WadeXl/bym-kestrel/renders/02_top.png

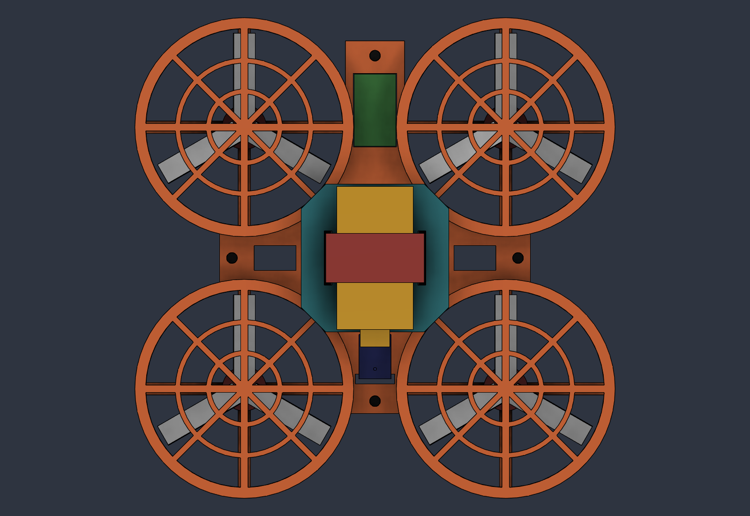
renders/02_top.png
