WadeXl/bym-kestrel/renders/03_front.png

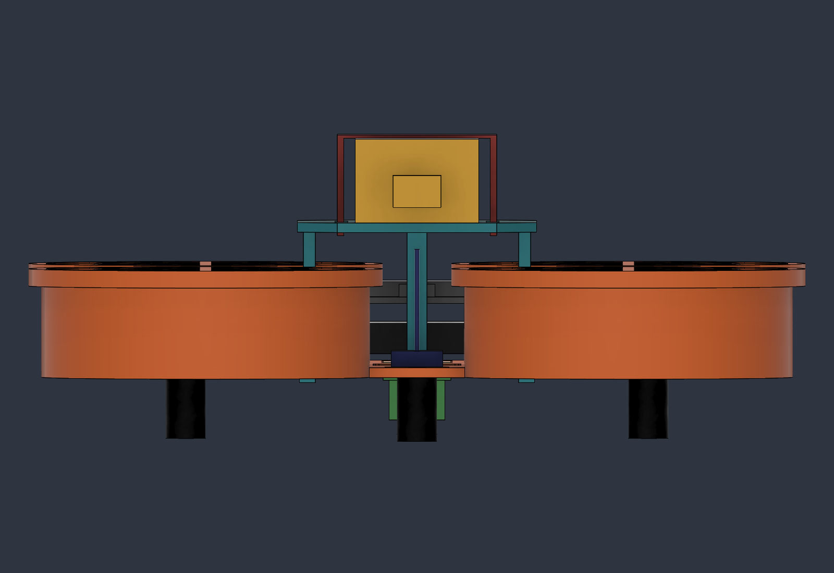
renders/03_front.png
