WadeXl/bym-kestrel/renders/04_bottom_flow_sensor.png

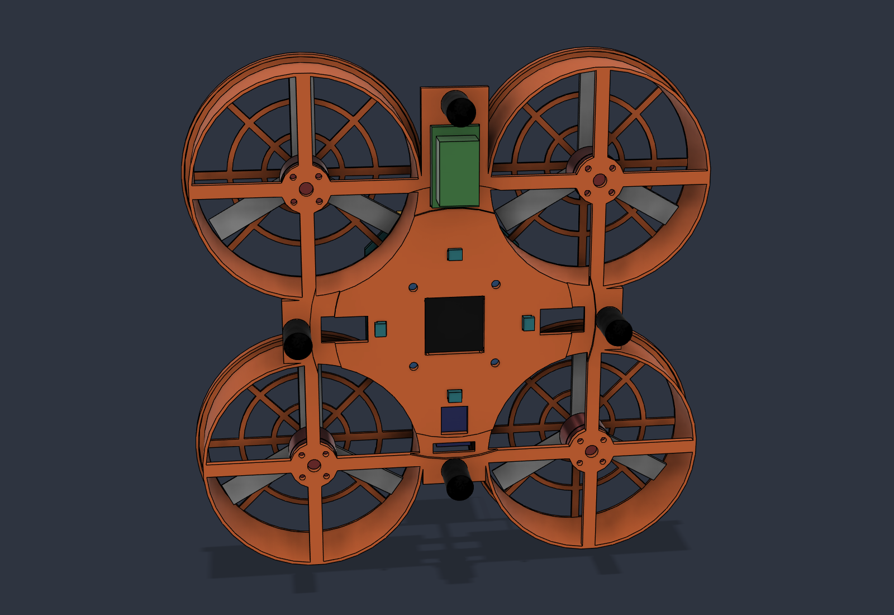
renders/04_bottom_flow_sensor.png
