WadeXl/bym-kestrel/renders/05_with_remote_bridge.png

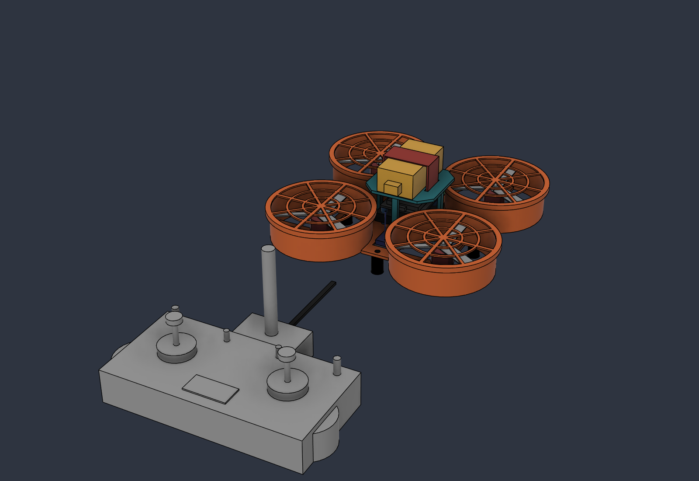
renders/05_with_remote_bridge.png
