WadeXl/bym-kestrel/renders/06_exploded.png

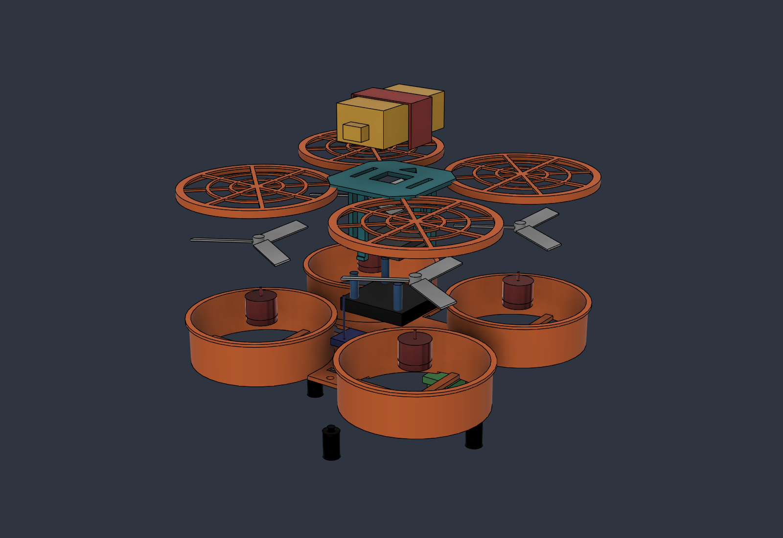
renders/06_exploded.png
