WadeXl/bym-kestrel/cad/K1_Assembly.step

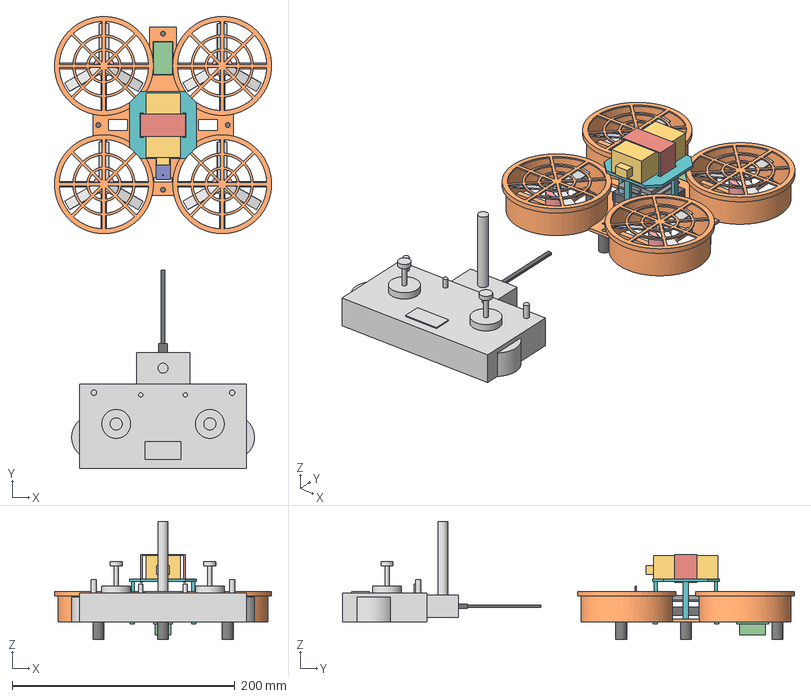
[picture p7: CAD file, 2026-11-09]
cad/K1_Assembly.step
194.8 x 405.4 x 106.0 mm
