WadeXl/bym-kestrel/cad/K1_P03_FingerGuard.step

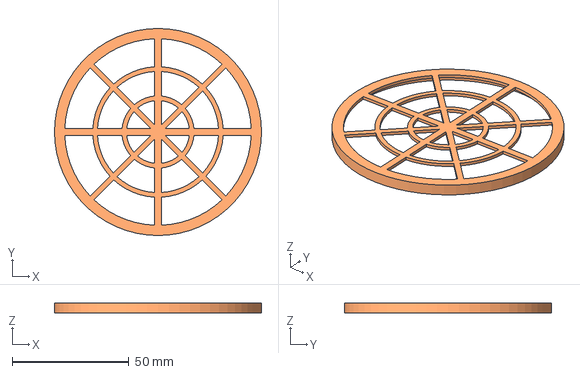
[picture p8: CAD file, 2026-11-09]
cad/K1_P03_FingerGuard.step
88.8 x 88.8 x 4.30 mm
