WadeXl/bym-kestrel/cad/K1_P02_Canopy_TopDeck.step

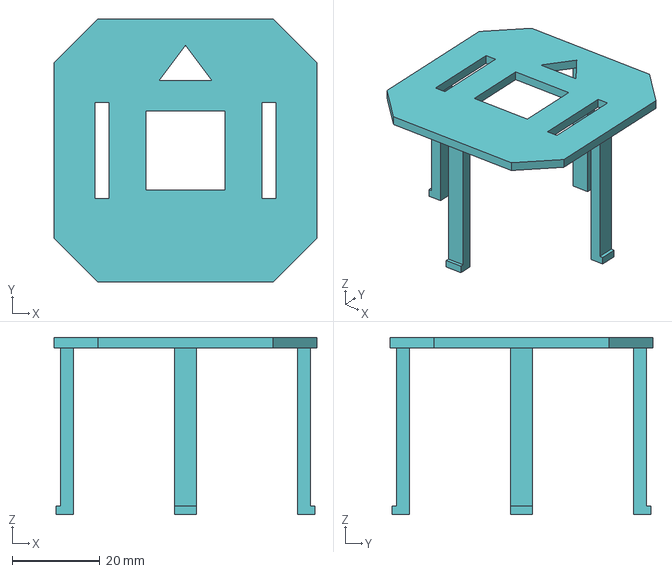
[picture p9: CAD file, 2026-11-09]
cad/K1_P02_Canopy_TopDeck.step
60.0 x 60.0 x 40.4 mm
