WadeXl/bym-kestrel/cad/K1_P01_Frame_DuctDeck.step

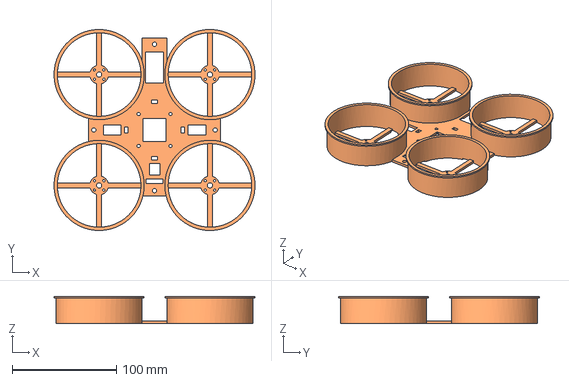
[picture p10: CAD file, 2026-11-09]
cad/K1_P01_Frame_DuctDeck.step
192.4 x 192.4 x 26.0 mm
