WadeXl/bym-kestrel/cad/K1_P04_BumperFoot_TPU.step

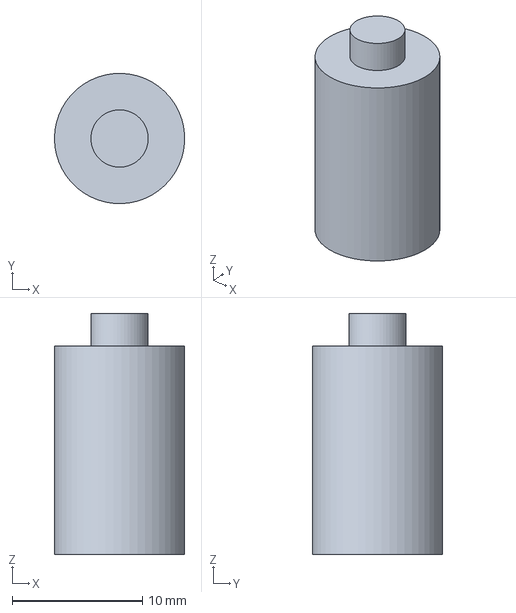
[picture p11: CAD file, 2026-11-09]
cad/K1_P04_BumperFoot_TPU.step
9.99 x 10.00 x 18.5 mm
