WadeXl/bym-kestrel/(list of files, cad)

Other CAD files:
cad/K1_P01_Frame_DuctDeck.stl
cad/K1_P02_Canopy_TopDeck.stl
cad/K1_P03_FingerGuard.stl
cad/K1_P04_BumperFoot_TPU.stl
